srobo-legacy/boards-servo-hw/gerbers/README.txt

Company: Student Robotics
Contact: Rich Barlow
Email:   rbarlow@studentrobotics.org
Phone:   XXXXXXXXXXXX
--------------------------------------------------------------------------------
Board Reference:  sr_servo
Board Issue:      13.F
--------------------------------------------------------------------------------
Board Details:
Bare Board Test:      Yes
Layers:               2
Copper Weight:        1oz
Material:             1.6mm FR4
Solder Resist:        GREEN on 2 sides
Silk Screen:          WHITE on 2 sides
--------------------------------------------------------------------------------
Panel Details:
Please panelise as appropriate for in-house assembly.
--------------------------------------------------------------------------------
Stack up:
top
bottom
--------------------------------------------------------------------------------
Included Files:

Board:
servo.top.gbr            - Top Copper Layer (Layer 1)
servo.bottom.gbr         - Bottom Copper Layer (Layer 2)
servo.topmask.gbr        - Solder Mask Top
servo.bottommask.gbr     - Solder Mask Bottom
servo.toppaste.gbr       - Solder Paste Top
servo.bottompaste.gbr    - Solder Paste Bottom
servo.topsilk.gbr        - Silk Screen Top
servo.bottomsilk.gbr     - Silk Screen Bottom
servo.outline.gbr        - Board Outline
servo.plated-drill.cnc   - Plated Hole Drill Information
servo.unplated-drill.cnc - Unplated Hole Drill Information

Assembly:
servo.fab.gbr            - Assembly drawing showing component locations
servo.xy.csv             - XY Placement Data
--------------------------------------------------------------------------------
If there are any problems please contact Rich Barlow using the details at
the top of this file.
