srobo-legacy/boards-servo-hw/case.dxf

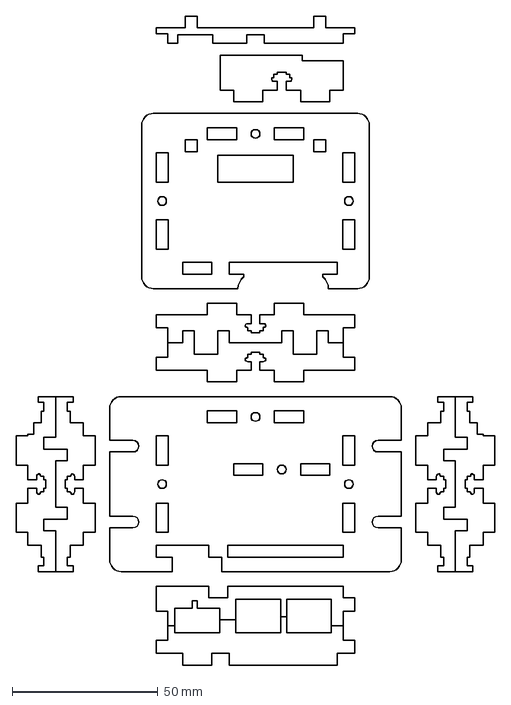
[picture p1: CAD file, 2011-03-14]
case.dxf
164.0 x 222.4 mm
