srobo-legacy/boards-servo-hw/(list of files, drawings)

Other design files:
servo.pcb
