srobo-legacy/boards-servo-hw/(commit log)

2010-04-01 Copy .gitignore, Makefile, gafrc and projectrc from motor repo.
    Modify files to refer to pwm board schematics/PCB layouts.
2010-04-01 Create schematic file and fill out title block
    [pwm.sch]
2010-04-02 Add in SRIC symbol, 3.3V regulator and MSP430.
    [pwm.sch]
2010-04-02 Add Vcc and GND symbols.
    Need to decide how to handle reverse polarity on the 12V coming in for the
    servo power rail. Will probably involve a second ground linked via a resistor
    to the actual ground.
    [pwm.sch]
2010-04-02 Add MSP430 programming header and reset pullup resistor
    [pwm.sch]
2010-04-02 Connect SRIC up to MSP430, use same pins as on motor controller
    [pwm.sch]
2010-04-02 Add external crystal
    [pwm.sch]
2010-04-02 Add debug/SRIC activity LED on same pin as motor controller
    [pwm.sch]
2010-04-02 Add buffers and pulldown resistors for servo channels
    [pwm.sch]
2010-04-02 Add in eight servo connectors
    Do the same as the current PWM board, have 8 servo headers but only 6 channels,
    headers 7 and 8 are duplicates of channels 5 and 6 allowing two servos to be
    controlled in tandem.
    [pwm.sch]
2010-04-04 Add components necessary for SMPS using A8498
    The A8498 can supply up to 3A, and the IC has a current limit of 3.5-5A.
    Although it's a bit vague it is high enough to power 6 servos under full load.
    The current of an average servo is about 600mA when fully loaded according to
    some 'Hobby Servo Fundmentals' PDF I found on the internet. The likely hood of
    all 8 servos being fully loaded at the same time is very low and a higher
    current SMPS would increase the cost and complexity of the circuit required
    significantly, 3A seems to be some kind of limit for ICs with integrated FETs.
    [pwm.sch]
2010-04-04 Wire up SMPS
    [pwm.sch]
2010-04-04 Add servo power camcon connector and reverse polarity protection FET.
    Use the same rev-pol protection scheme as on the new motor controller. Uses a
    single n-channel MOSFET, is much more efficient than a diode and is cheaper.
    [pwm.sch]
2010-04-04 Add power connections for buffer, resistor linking two grounds.
    As there is no isolation between the 'logic' and 'power' sides of the PWM
    board there needs to be a link between the two grounds which allows the
    current from signals to pass but blocks high currents that would occur if the
    board was wired incorrectly. The buffer IC is powered from the servo 5V rail
    therefore the only current flowing through the ground link resistor under
    normal circumstances will be the input leakage current of the IC.
    If the servo power connector polarity is reversed then the SGND node will be at
    ~12V (the whole of the power side will be around 12V, there is no problem with this). Current will flow through the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
    [pwm.sch]
2010-04-04 Add power LED to servo 5V rail. Add zener clamped sense inputs to MSP430
    Both the servo 5V rail and servo ground rail are connected to the MSP430,
    clamped via zener diodes, to allow the detection of power and also dodgy
    wiring. If the power is connected the wrong way around then both the 'S5V' and
    'SGND' nodes will be >3.3V so both inputs will be detectable as high. Under
    normal circumstances only the 'S5V' input should be high. The 'SGND' input
    indicates a fault.
    [pwm.sch]
2010-04-04 Assign refdes's to components
    [pwm.sch]
2010-04-04 Assign sr part numbers to components I definitely know the value of
    [pwm.sch]
2010-04-04 Move servo 5V power LED to somewhere a little less cramped
    [pwm.sch]
2010-04-04 Set value of zener clamp resistors to 1k
    Use 1k instead of 560R as used in old PWM board as up to 12V could potentially
    be present.
    [pwm.sch]
2010-04-04 Assign values to last few components that don't require calculation
    [pwm.sch]
2010-04-04 Calculate and assign values for SMPS feedback resistors.
    The values chosen give an output of 5.17V
    [pwm.sch]
2010-04-04 Set value of buffer IC. Don't see why the old PWM board had ACT, use HCT.
    [pwm.sch]
2010-08-05 Move the HasTOKEN input on the MSP to a pin with interrupts
    P1 and P2 have interrupt-on-change capabilities, so change the
    HasTOKEN needs to be connected to one of these.
    [pwm.sch]
2010-10-27 Remove refdes numbering and update to the latest SRIC with a 3.3V reg
    SRIC now has a 3.3V reg already so there is no need for the small 3.3V
    reg that was in the design before.
    [pwm.sch]
2010-10-27 Remove the old SMPS stuff, will replace with something beefier
    [pwm.sch]
2010-10-27 Draw most of new SMPS based of jointio board SMPS design
    [pwm.sch]
2010-10-27 Add p-channel switching FET to SMPS
    [pwm.sch]
2010-10-27 Update Makefile to be the same as the jointio board one
2010-10-27 Move the 5V SMPS power LED into a more sensible place on the schematic
    [pwm.sch]
2010-10-27 Add some 1k resistors between the MSP and the buffers
    I think it could be possible for 12V to be injected into the MSP if
    12V is connected to both of the power camcon terminals. All of the
    stuff on the high current side would be brought up to 12V, including
    the ground net. Current could then flow from the 'SGND' net, through
    the buffer input clamping diodes, into the MSP. The 1k resistors will
    limit this current.
    [pwm.sch]
2010-10-27 Move the HT line to a pin that's physically next to the rest of the SRIC lines
    [pwm.sch]
2010-10-27 Set values of most SMPS components. Set peak current limit to 5.8A
    [pwm.sch]
2010-10-27 Set values of SMPS feedback resistors
    [pwm.sch]
2010-10-27 Remove superfluous power LED on the SRIC 3.3V rail
    [pwm.sch]
2010-10-27 Add values to the SMPS inductor and diode
    [pwm.sch]
2010-10-27 Add a second 22uF input cap to the SMPS
    [pwm.sch]
2010-10-27 Add a couple of 220uF electrolytic caps to the 5V SMPS rail
    [pwm.sch]
2010-10-27 Reduce the value of the 5V SMPS rail power LED resistor to 330 ohms
    [pwm.sch]
2010-10-27 Add footprint attributes to all components that use existing footprints
    [pwm.sch]
2010-10-27 Correct value of the hex buffer
    [pwm.sch]
2010-10-27 Change cap symbol for 220uF caps to show polarisation
    [pwm.sch]
2010-10-27 Add FET to allow software control of the SMPS
    [pwm.sch]
2010-10-27 Swap the zener diode symbols for ones that have the correct pin numbering
    [pwm.sch]
2010-10-27 Assign refdeses to all of the components
    [pwm.sch]
2010-10-27 Remove the second DIP footprint attribute from the buffer
    Damn gEDA and it's annoying default symbols
    [pwm.sch]
2010-10-27 Correct the part name of the SMPS diode
    [pwm.sch]
2010-10-27 Add 'sr_0603' footprint to some resistors that got missed
    [pwm.sch]
2010-12-15 Assign footprint values to the SMPS diode and inductor
    The diode symbol had to be changed to suit the pad layout of the package.
    [pwm.sch]
2010-12-15 Add 'source' attribute to the SRIC symbol
    [pwm.sch]
2010-12-17 Generate PCB layout. Setup DRC rules for layout
    [pwm.pcb]
2010-12-17 Insert the standard SRIC layout
    [pwm.pcb]
2010-12-17 Place all components in the layout
    [pwm.pcb]
2010-12-17 Update 'Skinny' routing style to be the smallest possible
    [pwm.pcb]
2010-12-17 Route all SMPS nets
    [pwm.pcb]
2010-12-17 Route power to the servo headers
    [pwm.pcb]
2010-12-17 Route control lines from hex inverter to servo headers
    [pwm.pcb]
2010-12-17 Route servo control signals from MSP to hex inverter
    [pwm.pcb]
2010-12-17 Route MSP programming and other misc signals
    [pwm.pcb]
2010-12-17 Connect MSP to SRIC signal lines
    [pwm.pcb]
2010-12-17 Route voltage detection clamping zener diodes
    [pwm.pcb]
2010-12-17 Move voltage detection lines onto different MSP pins to ease routing
    [pwm.pcb, pwm.sch]
2010-12-17 Connect voltage detection lines to the MSP
    [pwm.pcb]
2010-12-17 Route last few traces
    [pwm.pcb]
2010-12-17 Rename this design to 'servo' to fit with the new naming convention
    The 'PWM Board' has been renamed to the 'Servo Board'. This design is
    being renamed to prevent any confusion.
    [servo.pcb, servo.sch]
2010-12-18 Move SRIC dual LED to the rear of the board
    The 'bottom' side of the board is going to be the side that's visible
    once mounted in the case.
    [servo.pcb]
2010-12-18 Move 'IN' and 'OUT' text to the bottom of the board
    The bottom side of the board is the one that will be visible when it's
    mounted in the case.
    [servo.pcb]
2010-12-18 Position refdeses
    [servo.pcb]
2010-12-18 Increase soldermask clearance on pins/pads where it's too small
    Some of the pins/pads had the soldermask clearance set too small. It needs
    to be at least 0.125mm.
    [servo.pcb]
2010-12-18 Reduce canvas size to the size of the actual board
    [servo.pcb]
2010-12-18 Move traces/refdeses in from the edge of the board
    After setting the size of the canvas to the size of the actual board
    some of the traces and refdeses were too close to the edge.
    [servo.pcb]
2010-12-23 Change the inverter/buffers between the MSP and servos to a 3-8 decoder
    There was always problems writing the firmware with the old design as it
    requires code to run at very specific times which is not possible when there's
    interrupts being fired as data comes in over I2C/SRIC. This led to the I2C/SRIC
    code having to be poll based, with the only interrupt being the timer for
    controlling the servos, without this they would jitter and be useless.
    This design uses a 3-8 decoder to direct the output of Timer B to an individual
    servo. The timer can control the width of the pulse sent to each servo very
    precisely. Each servo is selected in turn and a pulse sent. This process is
    repeated continuou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
    [servo.sch]
2010-12-23 Renumber resistors to be more logical
    After swapping the inverters out the refdeses of the resistors got quite
    messy and were all over the place.
    [servo.sch]
2010-12-23 Change the IC power symbol for the 3-8 decoder to one for a 16-pin device
    It still had a 14-pin device power symbol from the hex inverter.
    [servo.sch]
2010-12-23 Use the correct ground net to pull inputs to the 3-8 decoder low
    The 'servo' side of things has its own ground net 'SGND' and this
    should be used to pull inputs to the 3-8 decoder low, not the normal
    'GND' net.
    Both of these nets will essentially be at the same potential under
    normal operation but the SGND net might be at 12V if the power connector
    is miswired.
    [servo.sch]
2010-12-23 Update .gitignore to match the new name of the board and the intermediate files
2010-12-23 Fix the mess in the PCB layout after renaming all of the resistors
    Lots of incorrectly placed resistors. All fixed now.
    [servo.pcb]
2010-12-23 Remove silkscreen cruft and restore some sanity to resistor refdeses
    The refdeses ended up splattered all over the shop after shuffling
    the resistors around into their new homes. There was also a few lines
    left on the silkscreen which originally outlined groups of resistors
    and their refdeses.
    [servo.pcb]
2010-12-23 Place and route new components/nets for 74HCT238
    [servo.pcb]
2010-12-23 Add some heatsink copper around the SMPS FET
    Got to keep that FET nice and cool :) It also helps to keep the inductor
    cool as the winding resistance dissipates a reasonable amount of power at
    5A.
    [servo.pcb]
2010-12-23 Add heatsink copper for the reverse polarity FET
    [servo.pcb]
2010-12-23 Remove slivers of copper plane
    Increase the clearance around some pins/pads/vias to cut of tiny
    bits of copper.
    [servo.pcb]
2010-12-23 Add ground plane underneath SMPS
    [servo.pcb]
2010-12-23 Add ground plane around 3-8 decoder
    [servo.pcb]
2010-12-24 Add ground plane around logic parts of the board on the solder side
    [servo.pcb]
2010-12-24 Add ground plane around logic parts on the component layer
    [servo.pcb]
2010-12-24 Add a TVS diode to the 5V rail
    [servo.sch]
2010-12-24 Add TVS diode to PCB layout
    [servo.pcb]
2010-12-24 Add text identifying the pinout of the servo connectors
    Had to shuffle a few components and traces around to get the text to fit
    in nicely.
    [servo.pcb]
2010-12-29 Correct the name of the board on the schematic
    Still had 'PWM' and 'pwm.sch' on the schematic. It now has 'Servo' and
    'servo.sch' respectively.
    [servo.sch]
2011-01-26 Add gerbers for a prototype run
    [servo.back.gbr, servo.fab.gbr, servo.front.gbr]
2011-02-18 Move and change value of cap in feedback network of SMPS
    After building a prototype I found that the SMPS was acting strangely.
    Rather than turning the FET on solidly at the start of a cycle it would
    oscillate at around 5MHz until the output has risen sufficiently. A large
    amount of this 5MHz signal was visible on both the output and the feedback
    line going into the control IC. I suspect this was being caused by the inductor
    inducing some form of noise into the feedback line from its magnetic field,
    the feedback network is positioned directly underneath the inductor. Moving the
    cap in the feedback network to the lower half forms a low-pass filter and
    stops the 5MHz signal completely.
    I've h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
    [servo.pcb, servo.sch]
2011-02-20 Add beginnings of the case design, currently a box with no cut-outs
    [case.dxf]
2011-02-20 Add rounded corners to the top and bottom panels of the case
    [case.dxf]
2011-02-20 Add cut-outs to the case design for the side-facing connectors
    [case.dxf]
2011-02-20 Increase the height of the case by 2mm
    I forgot to include the thickness of the PCB when working out how high
    the case needs to be
    [case.dxf]
2011-02-20 Add the cut-out for the servo headers to the case
    [case.dxf]
2011-02-20 Split the side panels of the case design in half
    [case.dxf]
2011-02-20 Add cable tie tabs to the side panels of the case
    [case.dxf]
2011-02-20 Add mounting slots to the base of the case
    [case.dxf]
2011-02-20 Add panels to support the PCB around the servo headers
    As there are only connectors on one edge of the PCB and they're quite far away
    from the servo headers there will be nothing supporting the PCB. The added
    panels provide support to the PCB both from above and below. This should stop
    it moving about both during plugging and unplugging servos.
    [case.dxf]
2011-02-20 Add a finger cut-out to the top panel for the SRIC plugs
    [case.dxf]
2011-03-09 Add ID text to the PCB
    [servo.pcb]
2011-03-09 Add gerbers used for final manufacture
    [servo.back.gbr, servo.backmask.gbr, servo.backpaste.gbr, servo.backsilk.gbr, servo.fab.gbr, servo.front.gbr, servo.frontmask.gbr, servo.frontpaste.gbr]
2011-03-09 Add README in gerbers dir for PCB fab
2011-03-10 Add a gerber for the board profile
    [servo.outline.gbr]
2011-03-14 Add stepped up gerbers
2011-03-14 Add gerbers used for the solder paste stencil
2011-03-14 Add clearance around a nut in one of the board supports
    When assembling the prototype I found that one of the nuts in the lid fouled
    the upper board support. This cut-out allows the support to fit around the nut.
    [case.dxf]
2011-03-14 Increase width of the slots by 0.1mm
    When assembling the motor board cases we found that the tolerance of the
    acrylic thickness meant that some side panels would not fix into the top/
    bottom panels. They only required a tiny amount of material removing to
    then fit correctly.
    [case.dxf]
2011-03-14 Add a cut-out to the base of the case for the camcon to lie in
    On the prototype it's currently impossible to plug a camcon into the socket
    due to the screw terminal block part fouling the bottom face. This cut-out
    allows it to fit snugly in.
    [case.dxf]
2012-06-28 Convert layout to the latest PCB format
    PCB now stores all sizes with units, hence the massive diff. The design itself
    has not changed at all in this commit.
    [servo.pcb]
2012-06-29 Increase the visibility of labels
    Added more SRIC IN/OUT labels and made existing labels more visible by
    duplicating them in copper where there's space. This doesn't change the board
    electrically.
    [servo.pcb]
2012-06-29 Add a box in silk for the board asset code
    [servo.pcb]
2012-08-16 Update gerbers to the latest design
    Looks like PCB's changed from calling the layers the "back" and
    "front" to the "bottom" and "top".
    [servo.back.gbr, servo.backpaste.gbr, servo.backsilk.gbr, servo.bottom.gbr, servo.bottommask.gbr, servo.bottompaste.gbr, servo.bottomsilk.gbr, servo.fab.gbr]
2012-08-16 Remove stepped gerbers
    These are now out-of-date, and we don't need them any more.
2012-08-16 Update PCB version label to "SR13.F"
    These are being manufactured for SR2013, so I believe this is the
    correct label.
    [servo.pcb]
2012-08-16 Update gerbers to include text label change
    [servo.bottom.gbr, servo.bottommask.gbr, servo.bottompaste.gbr, servo.bottomsilk.gbr, servo.fab.gbr, servo.top.gbr, servo.topmask.gbr, servo.toppaste.gbr]
2012-09-12 Add polarity markings to silkscreen near 12V input
    [servo.pcb]
2012-09-12 Update the gerbers to include the latest change
    [servo.bottom.gbr, servo.bottommask.gbr, servo.bottompaste.gbr, servo.bottomsilk.gbr, servo.fab.gbr, servo.top.gbr, servo.topmask.gbr, servo.toppaste.gbr]
2012-12-23 Add makefile target to generate pdf of schematic
2013-08-03 Modify FET to one that's manufactured
    The old one is no longer manufactured. The one has a higher continuous
    current rating and a lower on resistance. The on resistance of the FET
    is used as part of the current limit, so this means that the current
    limit will be higher with this FET.
    [servo.pcb, servo.sch]
2013-08-04 Update README and add XY placement file
    [servo.xy.csv]
